Kazenzi/The-robotic-farmer/README.md

# 🚜 Decentralized Robotic Farming 🤖

Click the Youtube Thumbnail below for a youtube demo video: 
<div align="center">
  <a href="http://www.youtube.com/watch?v=3aW1EPtWOO4" target="_blank" style="position: relative; display: inline-block;">
    Video Title
    YouTube Logo
  </a>
</div>

## Overview

*Decentralized Robotic Farming* a.k.a "The Robotic Farmer" is an innovative solution that combines IoT technology and blockchain to enhance transparency, efficiency, and trust in agricultural practices. Our application enables real-time monitoring of farm conditions and automatic mechanized responses to address issues, all while securely storing farming data for easy access. The Robotic Farmer aims to improve crop yields, reduce resource wastage, and foster a more sustainable agricultural ecosystem.

Play with it live on: **[https://mkulima-welcome.vercel.app/](https://mkulima-welcome.vercel.app/)**

Our application applies the use of a smart contract deployed on the Base Mainnet. To verify, click [here](https://basescan.org/tx/0xa0cec8370d50e3738e3875305d2406a3c49cf04a951348cc5778b26b3b8fc69f) 

Proof that we have made 1+ transactions on Base for the project: [Transactions Made by mrsamuelkaruingi.base.eth](https://basescan.org/address/0xe854a712AE100D1089e1490179Ea1C1F786b56cc)

Contract Address: 0xcbb03c0470c16f5e1065cc8379252062e0d8d3d4

To explore further details, visit [BaseScan](https://basescan.org/) and paste the contract address above.

## <u>Table of Contents</u>
- [Problem Statement](#problem-statement)
- [Our Solution](#our-solution)
- [Key Features](#key-features)
- [Research Avenues](#research-avenues)
- [Installation](#installation)
- [Usage](#usage)
- [Future Enhancements](#future-enhancements)
- [Contributors](#contributors)
- [License](#license)

## Problem Statement

Agriculture today faces several challenges:
- Lack of trust and transparency between stakeholders.
- Absence of mechanized systems to respond to changing conditions.
- No proof of proper farming conditions, leading to wrongful accusations.
- Limited access to reliable, data-driven decision-making tools.

## Our Solution

We leverage IoT-enabled agriculture combined with Web 3 integration to create a robust platform for monitoring and managing farm conditions:
- *Real-time Monitoring*: Continuous data collection from various sensors.
- *Autonomous Robotics*: Implementation of robotic systems that autonomously perform tasks such as irrigation and fertilization based on real-time data.
- *Blockchain Storage*: Immutable records stored on IPFS, ensuring tamper-proof data.
- *Smart Contracts*: Automated updates and audits for all farm operations.

## Key Features

- *IoT Sensors*: Utilizes ultrasonic, soil temperature, water level, moisture, rainfall, and NPK sensors.
- *Automation*: Automatically manages irrigation and nutrient dosing based on real-time data.
- *Transparent Record-Keeping*: Immutable records on the blockchain provide legal protection for farmers.
- *Data Accessibility*: Stakeholders can access real-time data and historical records through an intuitive dashboard.
  
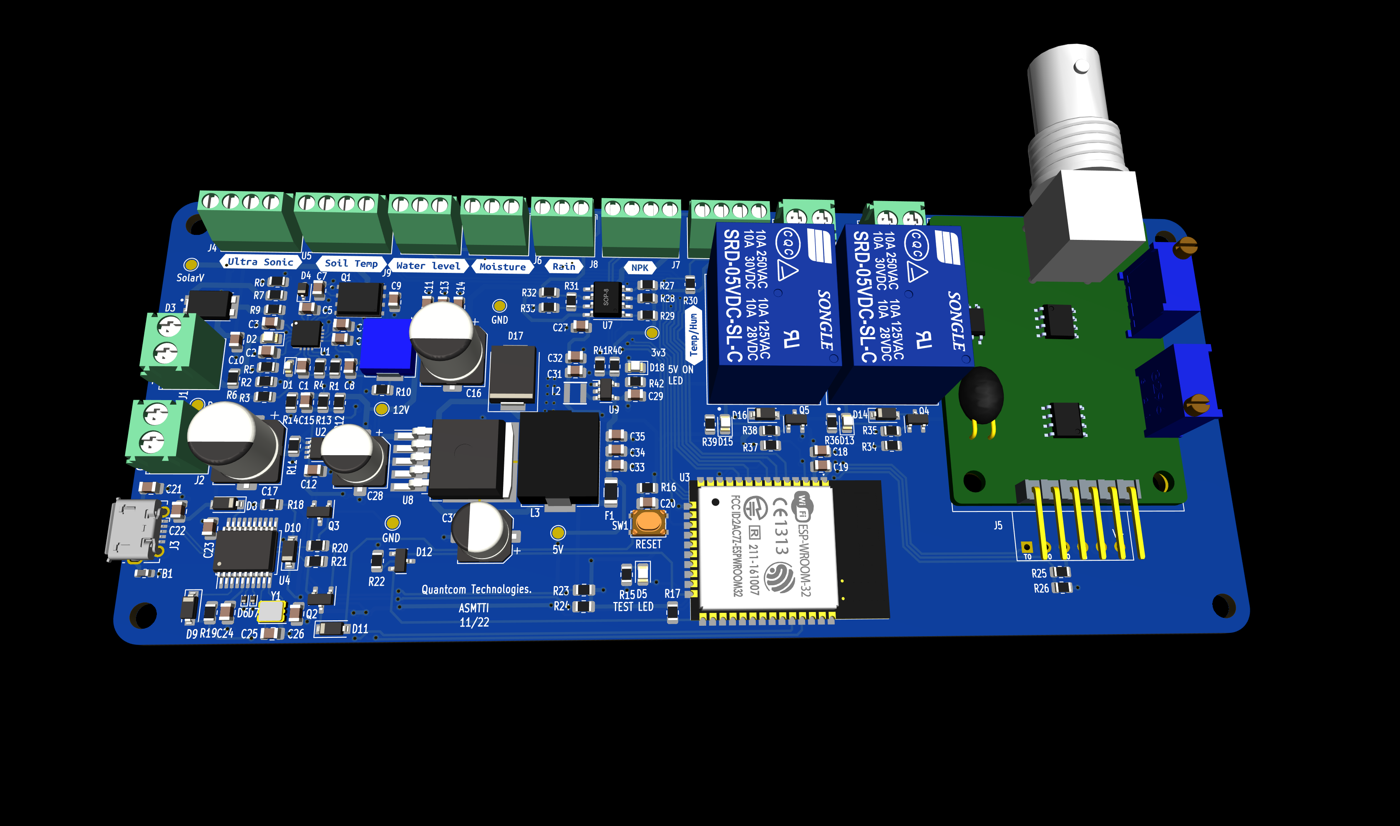
[picture p1: hardware_top.png]

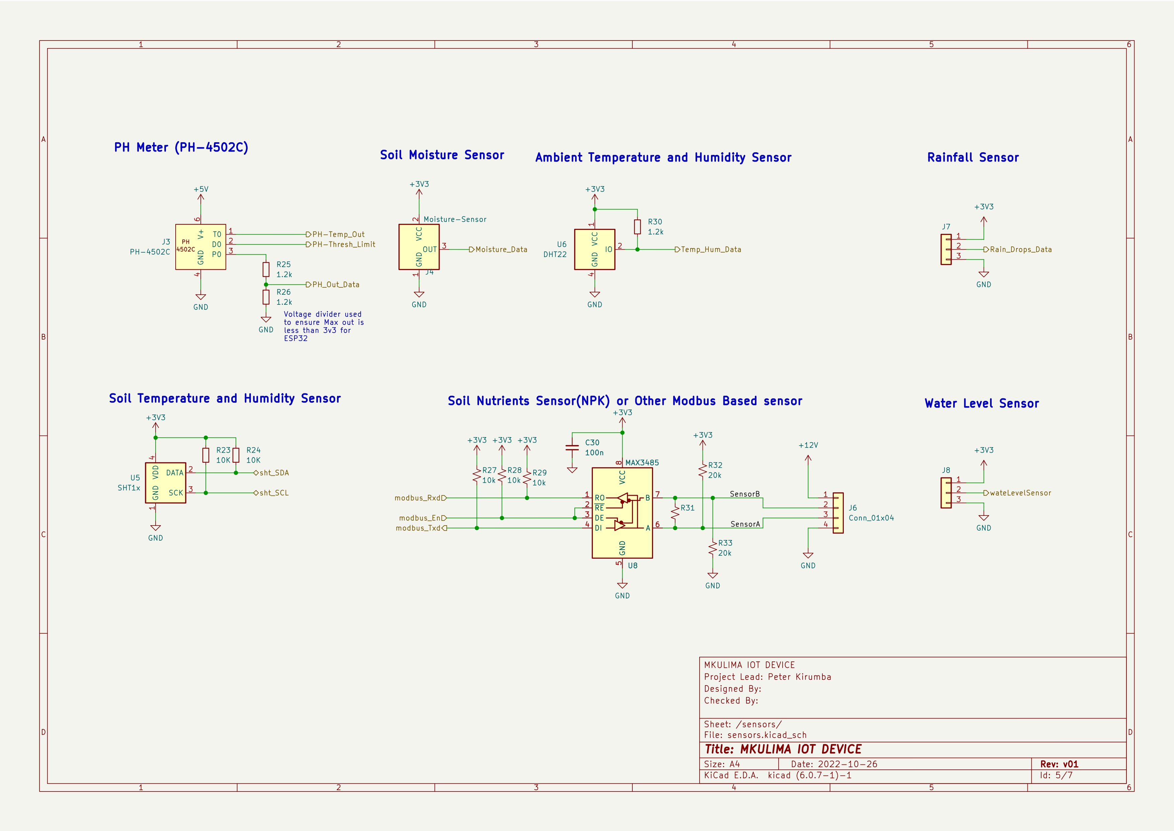
[picture p2: IoT-skeleton-setup.jpg]

<div align="center">
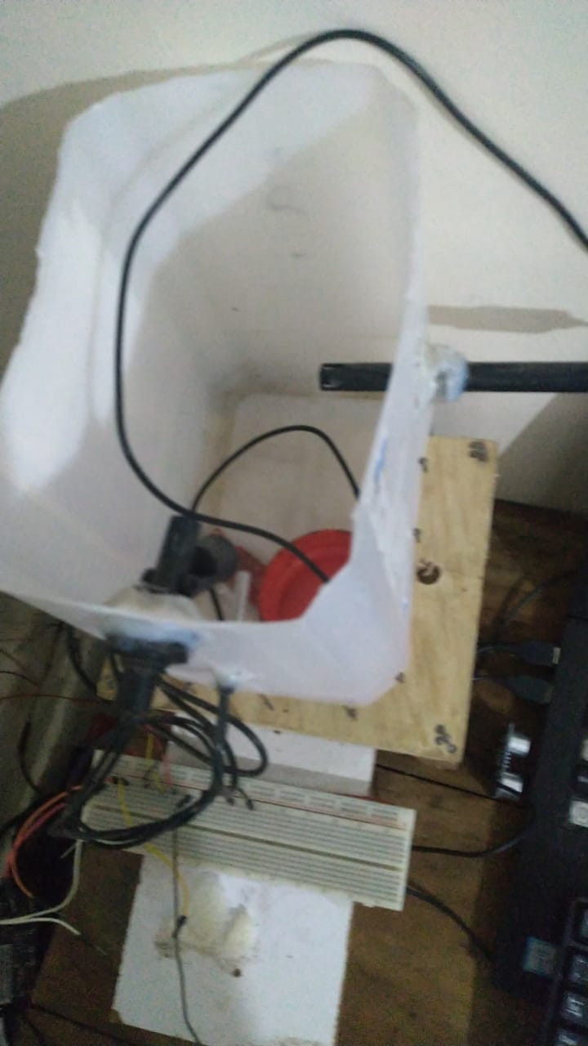
[picture p3: board.jpeg]
Description
    
</div>  

<br><br>

## Research Avenues
**1. Computer and Electrical/Electronics Engineering**

**2. Mechatronics and Robotics Engineering**

**3. Microprocessor Technology/ Embedded Systems** 

**4. Instrumentation and Control**

**5. Physics and Solar Energy**
   
<br>

Play with it live on: **[https://mkulima-welcome.vercel.app/](https://mkulima-welcome.vercel.app/)**

## Installation

**NOTE:** Code to control the hardware can be found in "mkulima_hardware/src". For IoT development strictly use equipment and documentation as specified. 

1. **Clone the Repository:**
   ```bash
   git clone https://github.com/Kazenzi/The-robotic-farmer.git
   cd The-robotic-farmer
   ```

2. **Install Dependencies:**
   ```bash
   npm install
   ```

   <br />

## Locally run

```sh
# Install bun in case you don't have it
curl -fsSL https://bun.sh/install | bash

# Install packages
bun i

# Run Next app
bun run dev
```
<br />

## Usage

1. **Run the Application:** Start the application by running:
   ```bash
   node index.js
   ```
   You will be prompted by your wallet (MetaMask or similar) to confirm the transaction for gas fees.
   As of the moment, the command will give you latest data from our testing phase but for more precise functionality, kindly use real sensors and connect the app to a bluetooth/wifi network to receive real-time data.
   
2. **Interact with the Smart Contract:**
   The `updateCID.js` script should update the IPFS CID for the latest sensor data automatically.
   - Confirm the transaction prompt when updating the CID.
   - You can use mock data to test the application if you do not have sensors.

The front end is fully functional and user-friendly. Ensure all necessary requirements are installed to run the app on your machine.
   
## Future Enhancements

- *Automatic Alerts*: Notifications for critical thresholds (e.g., low water levels).
- *Gas Fee Estimation*: Display gas fee estimates before transactions.
- *Offline Functionality*: Access sensor data offline.
- *Data Visualizations*: Implement charts for data trends over time to help farmers make informed decisions.

## Contributors

- [Samuel Njoroge](https://github.com/sammmmlikescoding)
- [Jacinta Kazenzi](https://github.com/Kazenzi)

## License

This project is licensed under the MIT License - see the [LICENSE](LICENSE) file for details.
