Kazenzi/The-robotic-farmer/hardware_side.png

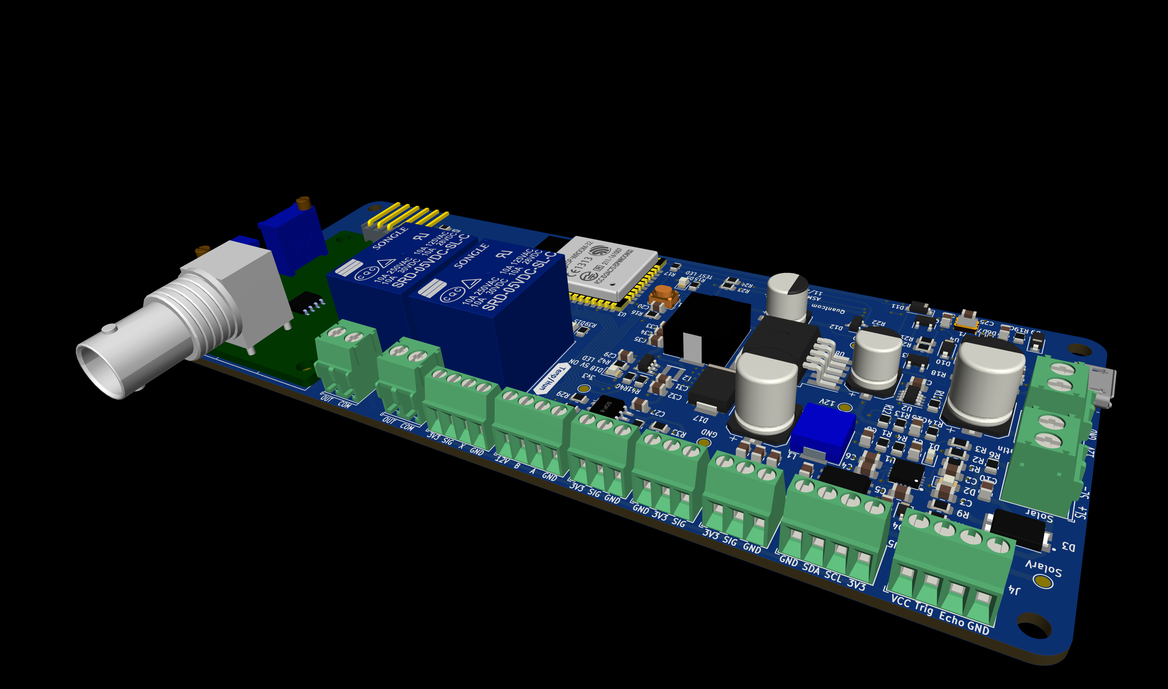
hardware_side.png
