Kazenzi/The-robotic-farmer/mkulima_hardware/img/mkulima_hardware_bottom.png

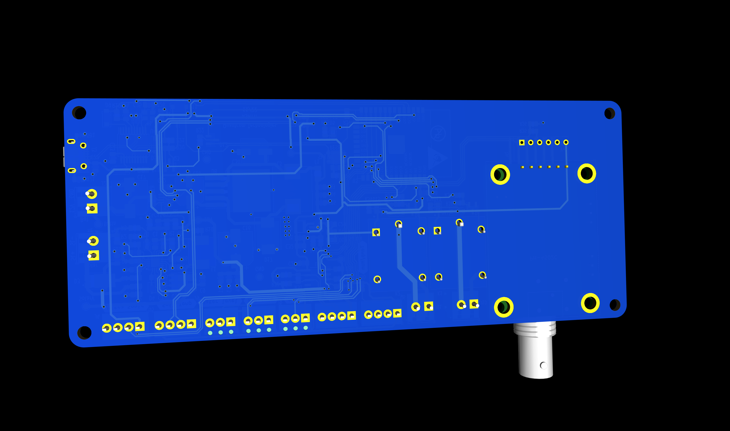
mkulima_hardware/img/mkulima_hardware_bottom.png
