Kazenzi/The-robotic-farmer/mkulima_hardware/img/mkulima_hardware_side_top1.png

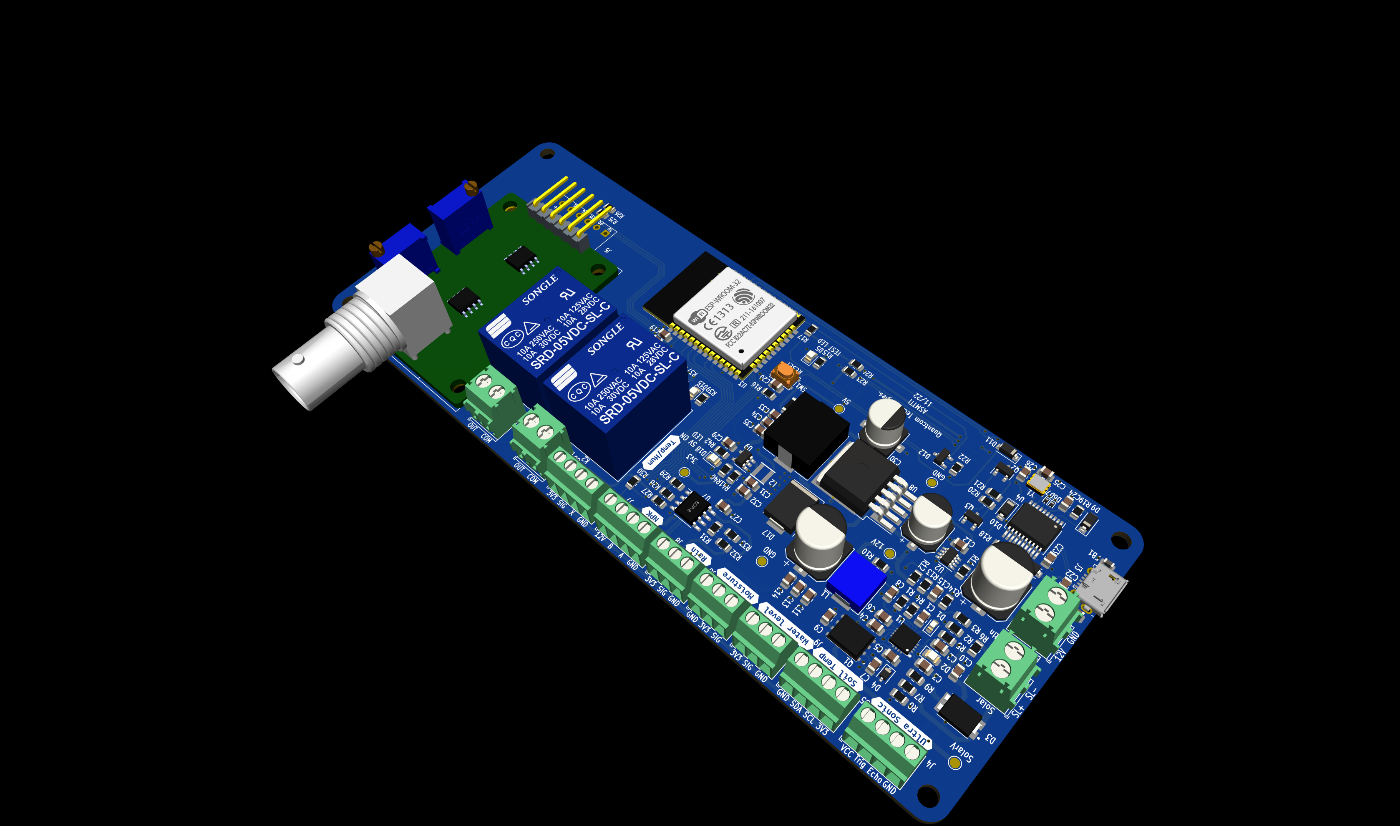
mkulima_hardware/img/mkulima_hardware_side_top1.png
