Kazenzi/The-robotic-farmer/public/robot-farmer.jpg

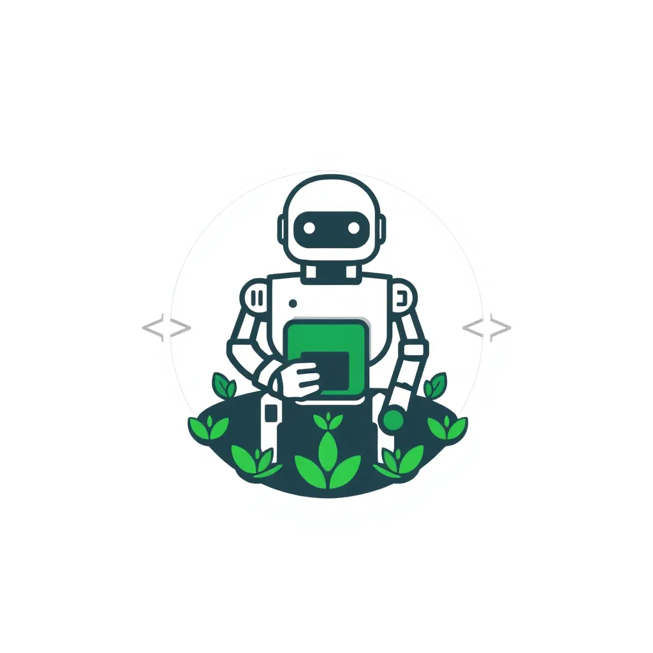
public/robot-farmer.jpg
