Kazenzi/The-robotic-farmer/mkulima_hardware/bom/mkulima_hardware.xlsx

Comment | Designator | Footprint | JLCPCB#
1u | C1, C2, C3, C7, C8, C10, C14, C20 | Capacitor_SMD:C_0805_2012Metric | C28323
0.1u | C4, C5, C6 | Capacitor_SMD:C_0805_2012Metric | C28233
10u | C9, C13, C18, C22, C34 | Capacitor_SMD:C_0805_2012Metric | C361063
47u | C11, C31 | Capacitor_SMD:C_0805_2012Metric | C76636
100n | C12, C19, C27, C32, C33, C35 | Capacitor_SMD:C_0805_2012Metric | C28233
22p | C15 | Capacitor_SMD:C_0805_2012Metric | C24658
22u | C16, C17 | Capacitor_SMD:CP_Elec_8x10 | C249488
10n | C21 | Capacitor_SMD:C_0805_2012Metric | C1710
22uF | C23 | Capacitor_SMD:C_0805_2012Metric | C602037
100nF | C24 | Capacitor_SMD:C_0805_2012Metric | C28233
22pF | C25, C26 | Capacitor_SMD:C_0805_2012Metric | C24658
470u | C28 | Capacitor_SMD:CP_Elec_6.3x7.7 | C393770
22u | C29 | Capacitor_SMD:C_0805_2012Metric | C602037
470u | C30 | Capacitor_SMD:C_0805_2012Metric | C393770
GREEN | D1 | LED_SMD:LED_0603_1608Metric | C84267
RED | D2 | LED_SMD:LED_0805_2012Metric | C434419
PDS1040 | D3 | greencharge-footprints:PDS104013 | C110512
D_Small | D4 | Diode_SMD:D_SOD-323 | C181207
LED_Small | D5, D13, D15, D18 | LED_SMD:LED_0805_2012Metric | C965790
D_TVS_Filled | D6, D7 | Diode_SMD:D_SOD-923 | C316040
D_Schottky_Small | D8 | Diode_SMD:D_SOD-123 | C908229
B5819W | D9, D10, D11 | Diode_SMD:D_SOD-123 | C8598
BAT54C | D12 | Package_TO_SOT_SMD:SOT-23 | C181200
D_Small | D14, D16 | Diode_SMD:D_SOD-123 | C908229
D_Small | D17 | Diode_SMD:D_SMC | C511858
ASMD1206-200 | F1 | Fuse:Fuse_1206_3216Metric | C135342
FerriteBead_Small | FB1 | Inductor_SMD:L_0603_1608Metric | C14709
Conn_01x02 | J1, J2 | TerminalBlock_Phoenix:TerminalBlock_Phoenix_PT-1,5-2-3.5-H_1x02_P3.50mm_Horizontal | C784942
USB_B_Micro | J3 | Connector_USB:USB_Micro-B_Molex-105017-0001 | C136000
Conn_01x04 | J4, J7 | TerminalBlock_Phoenix:TerminalBlock_Phoenix_MPT-0,5-4-2.54_1x04_P2.54mm_Horizontal | C2691448
Moisture-Sensor | J6 | TerminalBlock_Phoenix:TerminalBlock_Phoenix_MPT-0,5-3-2.54_1x03_P2.54mm_Horizontal | C49257
Conn_01x03 | J8, J9 | TerminalBlock_Phoenix:TerminalBlock_Phoenix_MPT-0,5-3-2.54_1x03_P2.54mm_Horizontal | C49257
Screw_Terminal_01x02 | J10, J11 | TerminalBlock_Phoenix:TerminalBlock_Phoenix_PT-1,5-2-3.5-H_1x02_P3.50mm_Horizontal | C784942
SRD-05VDC-SL-C | K1, K2 | greencharge-footprints:SRD-05VDC-SL-C | C35449
3.3uH | L1 | greencharge-footprints:MHCI06030-3R3M-R8 | C108294
2.2u | L2 | greencharge-footprints:NR3015T2R2M | C86423
33u | L3 | greencharge-footprints:YSPI1050-xxx | YSPI1050-3R3M
SI7288DP-T1-GE3 | Q1 | greencharge-footprints:SI7288DP-T1-GE3 | C126988
MMBT3904 | Q2, Q3, Q4, Q5 | Package_TO_SOT_SMD:SOT-23 | C20526
5.23k | R1 | Resistor_SMD:R_0805_2012Metric | C304851
30.1k | R2 | Resistor_SMD:R_0805_2012Metric | C21841
10k | R3, R4, R6, R17, R18, R19, R20, R21, R27, R28, R29 | Resistor_SMD:R_0805_2012Metric | C17414
100R | R5 | Resistor_SMD:R_0805_2012Metric | C17408
499k | R7, R13 | Resistor_SMD:R_0805_2012Metric | C17721
36k | R8 | Resistor_SMD:R_0805_2012Metric | C4360
10R | R9 | Resistor_SMD:R_0805_2012Metric | C17415
0.002R | R10 | Resistor_SMD:R_0805_2012Metric | WW08RR002FTL
0.1R | R11 | Resistor_SMD:R_0805_2012Metric | C125639
0R | R12 | Resistor_SMD:R_0805_2012Metric | C17477
100k | R14 | Resistor_SMD:R_0805_2012Metric | C149504
220R | R15 | Resistor_SMD:R_0805_2012Metric | C17557
10k | R16 | Resistor_SMD:R_0805_2012Metric | C17414
220R | R22 | Resistor_SMD:R_0805_2012Metric | C17557
10K | R23, R24 | Resistor_SMD:R_0805_2012Metric | C17414
1.2k | R25, R26, R30 | Resistor_SMD:R_0805_2012Metric | C17379
~ | R31 | Resistor_SMD:R_0805_2012Metric | C17477
20k | R32, R33 | Resistor_SMD:R_0805_2012Metric | C4328
470R | R34, R36, R37, R39, R42 | Resistor_SMD:R_0805_2012Metric | C17710
10k | R35, R38 | Resistor_SMD:R_0805_2012Metric | C17414
220k | R40 | Resistor_SMD:R_0805_2012Metric | C17556
49.9k | R41 | Resistor_SMD:R_0805_2012Metric | C17719
SW_Push | SW1 | greencharge-footprints:SKRPACE010 | C139797
BQ24650RVAR | U1 | greencharge-footprints:BQ24650RVAR | C53712
INA219AxDCN | U2 | Package_TO_SOT_SMD:SOT-23-8 | C87469
ESP-32S | U3 | greencharge-footprints:ESP-32S | C701341
CH340T(SSOP20W) | U4 | Package_SO:SSOP-20_5.3x7.2mm_P0.65mm | C8689
SHT1x | U5 | TerminalBlock_Phoenix:TerminalBlock_Phoenix_MPT-0,5-4-2.54_1x04_P2.54mm_Horizontal | C918122
DHT22 | U6 | TerminalBlock_Phoenix:TerminalBlock_Phoenix_MPT-0,5-4-2.54_1x04_P2.54mm_Horizontal | C918122
MAX3485 | U7 | Package_SO:SOP-8_3.9x4.9mm_P1.27mm | C519082
LM2596S-5.0 | U8 | Package_TO_SOT_SMD:TO-263-5_TabPin3 | C347421
SY8089AAAC | U9 | Package_TO_SOT_SMD:SOT-23-5 | C78988
12MHz | Y1 | Crystal:Crystal_SMD_2520-4Pin_2.5x2.0mm | C90603
SHT1x | U5 | TerminalBlock_Phoenix:TerminalBlock_Phoenix_MPT-0,5-4-2.54_1x04_P2.54mm_Horizontal | C2880291
DHT22 | U6 | TerminalBlock_Phoenix:TerminalBlock_Phoenix_MPT-0,5-4-2.54_1x04_P2.54mm_Horizontal | C2880291
