Kazenzi/The-robotic-farmer/mkulima_hardware/src/mkulima_hardware.kicad_pcb

## KiCad design mkulima_hardware/src/mkulima_hardware.kicad_pcb (2024-10-19)

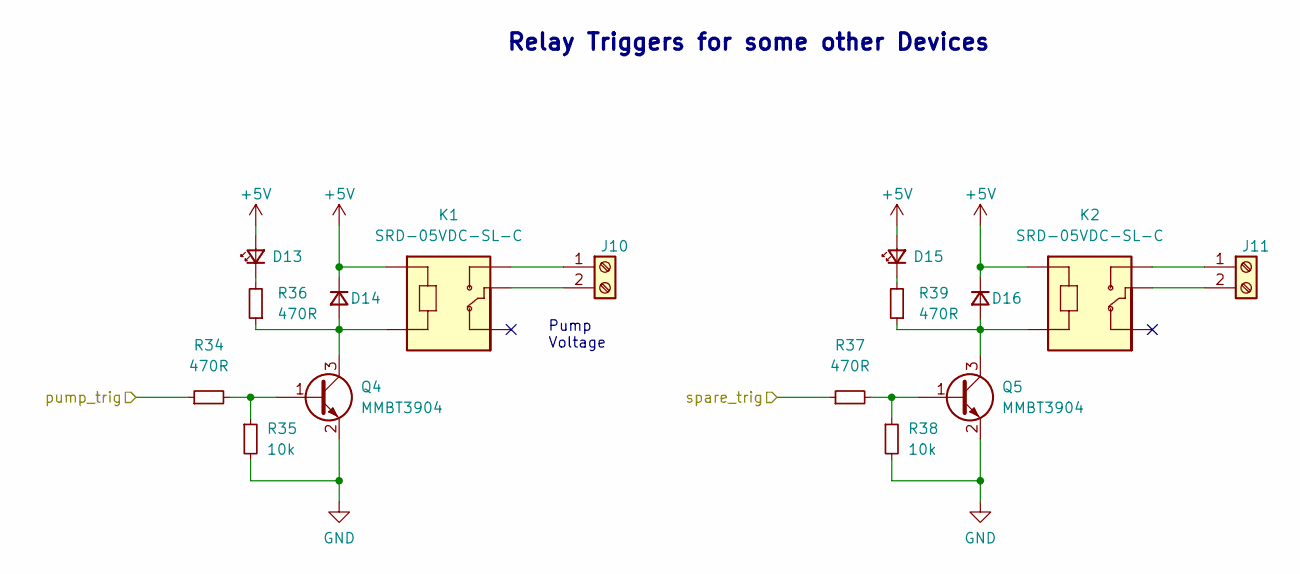
[picture p8: schematic actuators.kicad_sch, MKULIMA IOT DEVICE]

Parts:
D13, D15: LED_Small; LED_0805_2012Metric
D14, D16: D_Small; D_SOD-123
J10, J11: Screw_Terminal_01x02; TerminalBlock_Phoenix_PT-1,5-2-3.5-H_1x02_P3.50mm_Horizontal
K1, K2: SRD-05VDC-SL-C
Q4, Q5: MMBT3904; SOT-23
R34, R36, R37, R39: 470R; R_0805_2012Metric
R35, R38: 10k; R_0805_2012Metric

Connections:
+5V: D13.2 (A), D14.1 (K), D15.2 (A), D16.1 (K), K1.A1, K2.A1; also elsewhere on the board
/ESP32_logic_control/pumpTrig: R34.1; also elsewhere on the board
/ESP32_logic_control/spareTrig: R37.1; also elsewhere on the board
unnamed: D13.1 (K), R36.2
unnamed: D14.2 (A), K1.A2, Q4.3 (C), R36.1
unnamed: D15.1 (K), R39.2
unnamed: D16.2 (A), K2.A2, Q5.3 (C), R39.1
unnamed: J10.1, K1.NO
unnamed: J10.2, K1.COM
unnamed: J11.1, K2.NO
unnamed: J11.2, K2.COM
unnamed: Q4.1 (B), R34.2, R35.1
unnamed: Q5.1 (B), R37.2, R38.1

Notes on the sheet:
Relay Triggers for some other Devices
Pump Voltage

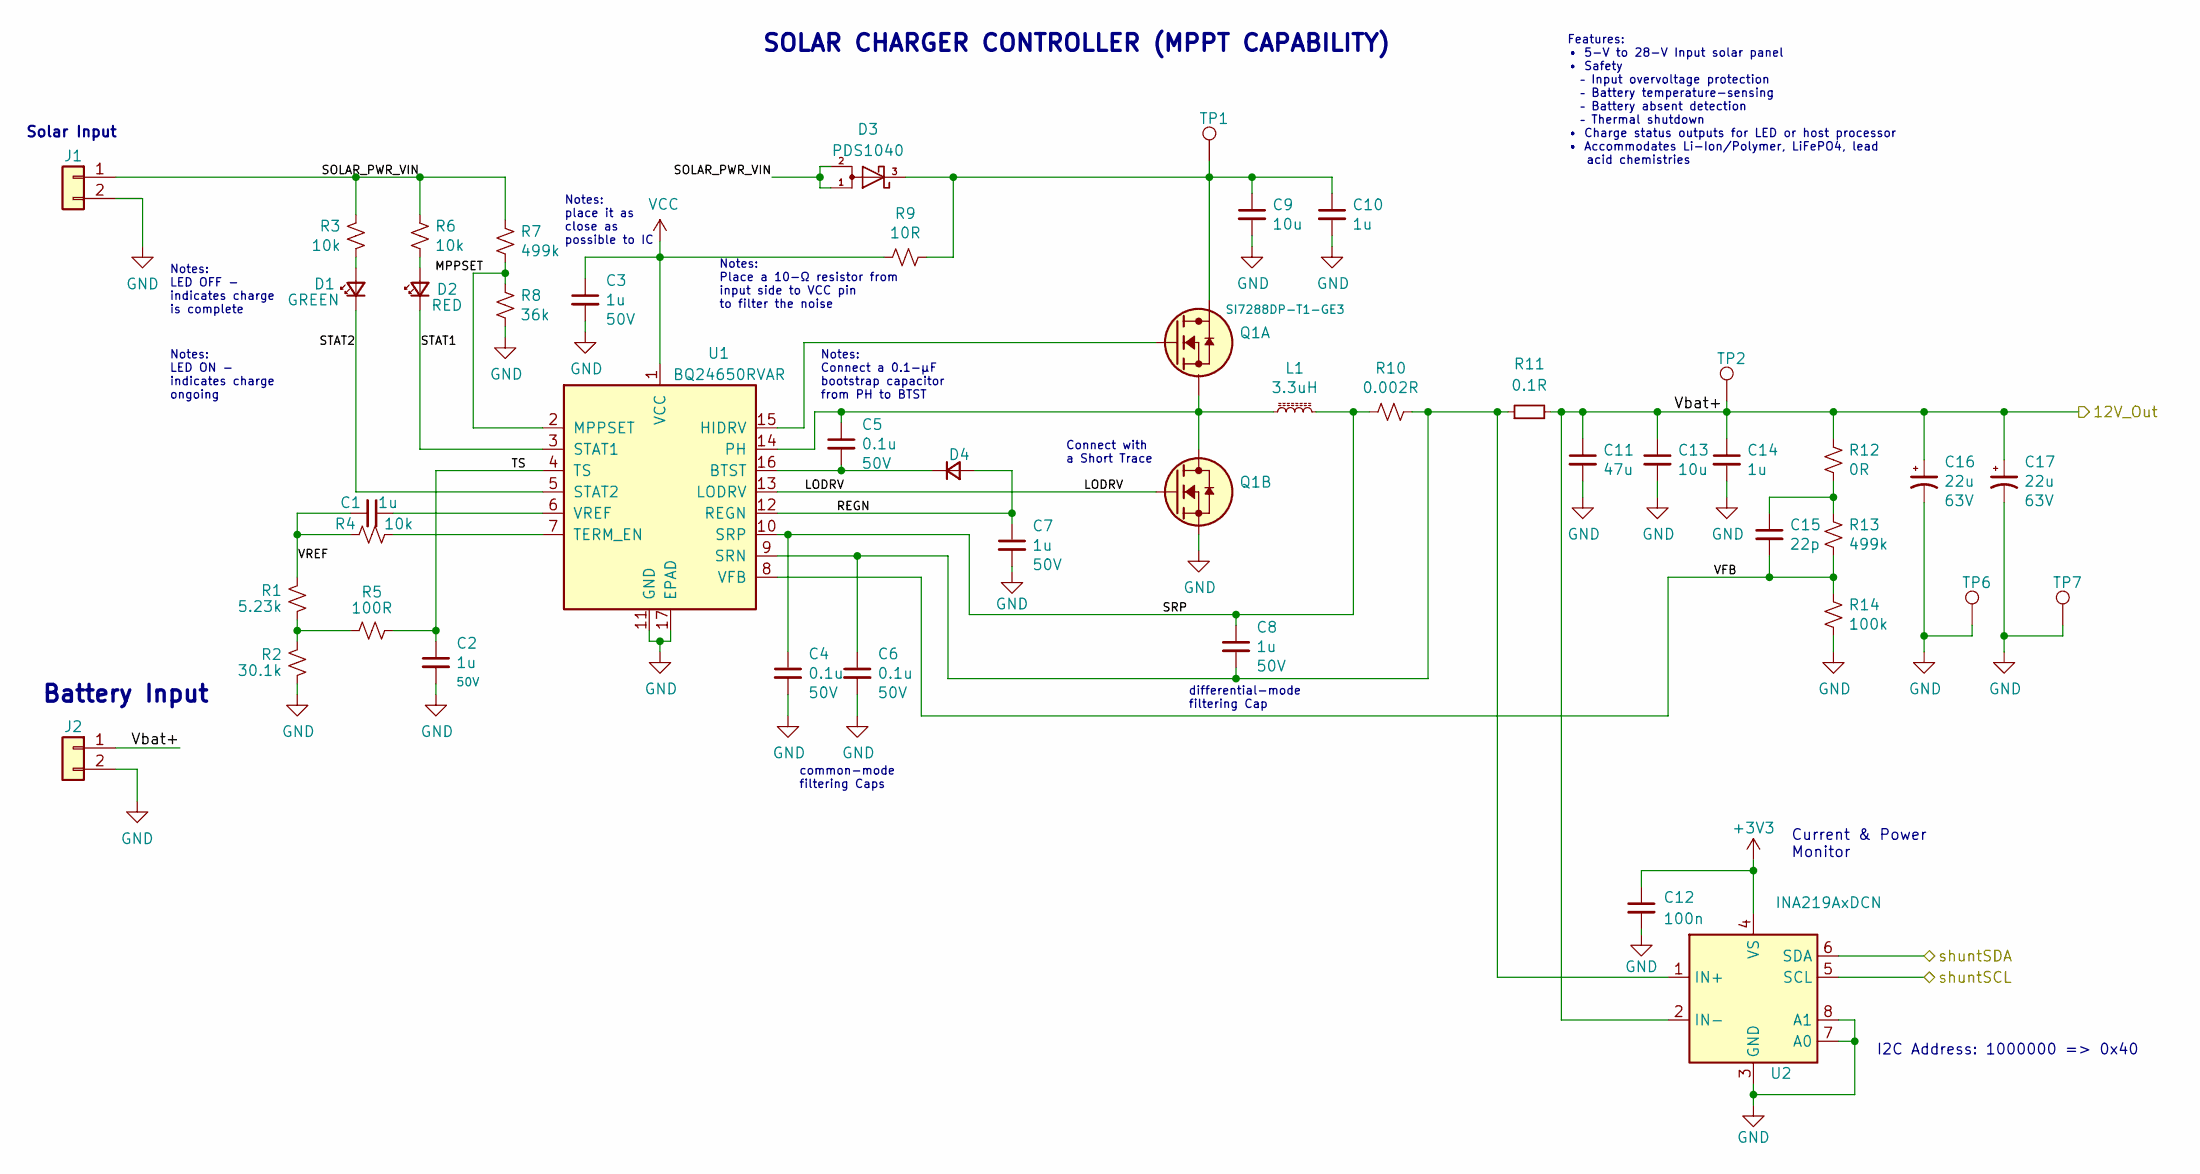
[picture p9: schematic solar_mppt_power_supply.kicad_sch, MKULIMA IOT DEVICE]

Parts:
C1, C10, C14: 1u; C_0805_2012Metric
C2, C3, C7, C8: 1u; C_0805_2012Metric; Voltage 50V
C4, C5, C6: 0.1u; C_0805_2012Metric; Voltage 50V
C9, C13: 10u; C_0805_2012Metric
C11: 47u; C_0805_2012Metric
C12: 100n; C_0805_2012Metric
C15: 22p; C_0805_2012Metric
C16, C17: 22u; CP_Elec_8x10; Voltage 63V; MPN VE-220M1JTR-0810
D1: GREEN; LED_0603_1608Metric
D2: RED; LED_0805_2012Metric
D3: PDS1040; PDS104013
D4: D_Small; D_SOD-323
J1, J2: Conn_01x02; TerminalBlock_Phoenix_PT-1,5-2-3.5-H_1x02_P3.50mm_Horizontal
L1: 3.3uH; MHCI06030-3R3M-R8; MPN MHCI06030-3R3M-R8
Q1: SI7288DP-T1-GE3; MPN SI7288DP-T1-GE3
R1: 5.23k; R_0805_2012Metric
R2: 30.1k; R_0805_2012Metric
R3, R4, R6: 10k; R_0805_2012Metric
R5: 100R; R_0805_2012Metric
R7, R13: 499k; R_0805_2012Metric
R8: 36k; R_0805_2012Metric
R9: 10R; R_0805_2012Metric
R10: 0.002R; R_0805_2012Metric
R11: 0.1R; R_0805_2012Metric
R12: 0R; R_0805_2012Metric
R14: 100k; R_0805_2012Metric
TP1, TP2, TP6, TP7: TestPoint; TestPoint_Pad_D1.5mm
U1: BQ24650RVAR
U2: INA219AxDCN; SOT-23-8

Connections:
+3V3: C12.1, U2.4 (VS); also elsewhere on the board
+12V: C11.1, C13.1, C14.1, C16.1, C17.1, J2.1, R11.2, R12.1, TP2.1, U2.2 (IN-); also elsewhere on the board
/scl: U2.5 (SCL); also elsewhere on the board
/sda: U2.6 (SDA); also elsewhere on the board
/solar_mppt_power_supply/LODRV: Q1.4, U1.13 (LODRV)
/solar_mppt_power_supply/MPPSET: R7.2, R8.1, U1.2 (MPPSET)
/solar_mppt_power_supply/REGN: C7.1, D4.2 (A), U1.12 (REGN)
/solar_mppt_power_supply/SOLAR_PWR_VIN: D3.1 (A), D3.2 (A), J1.1, R3.1, R6.1, R7.1
/solar_mppt_power_supply/SRP: C4.1, C8.1, L1.2, R10.2, U1.10 (SRP)
/solar_mppt_power_supply/STAT1: D2.1 (K), U1.3 (STAT1)
/solar_mppt_power_supply/STAT2: D1.1 (K), U1.5 (STAT2)
/solar_mppt_power_supply/TS: C2.1, R5.1, U1.4 (TS)
/solar_mppt_power_supply/VFB: C15.2, R13.2, R14.1, U1.8 (VFB)
/solar_mppt_power_supply/VREF: C1.2, R1.1, R4.2
unnamed: C1.1, U1.6 (VREF)
unnamed: C5.1, L1.1, Q1.1, Q1.5, Q1.6, Q1.10, U1.14 (PH)
unnamed: C5.2, D4.1 (K), U1.16 (BTST)
unnamed: C6.1, C8.2, R10.1, R11.1, U1.9 (SRN), U2.1 (IN+)
unnamed: C9.1, C10.1, D3.3 (K), Q1.7, Q1.8, Q1.9, R9.1, TP1.1
unnamed: C15.1, R12.2, R13.1
unnamed: D1.2 (A), R3.2
unnamed: D2.2 (A), R6.2
unnamed: Q1.2, U1.15 (HIDRV)
unnamed: R1.2, R2.1, R5.2
unnamed: R4.1, U1.7 (TERM_EN)
VCC: C3.1, R9.2, U1.1 (VCC)

Notes on the sheet:
Notes: Place a 10-Ω resistor from input side to VCC pin to filter the noise
differential-mode filtering Cap
Features: • 5-V to 28-V Input solar panel • Safety – Input overvoltage protection – Battery temperature-sensing – Battery absent detection – Thermal shutdown • Charge status outputs for LED or host processor • Accommodates Li-Ion/Polymer, LiFePO4, lead acid chemistries
Notes: LED OFF - indicates charge is complete
Solar Input
Notes: Connect a 0.1-μF bootstrap capacitor from PH to BTST
Notes: LED ON - indicates charge ongoing
Connect with a Short Trace
Current & Power Monitor
Notes: place it as close as possible to IC
common-mode filtering Caps
Battery Input
SOLAR CHARGER CONTROLLER (MPPT CAPABILITY)
I2C Address: 1000000 => 0x40

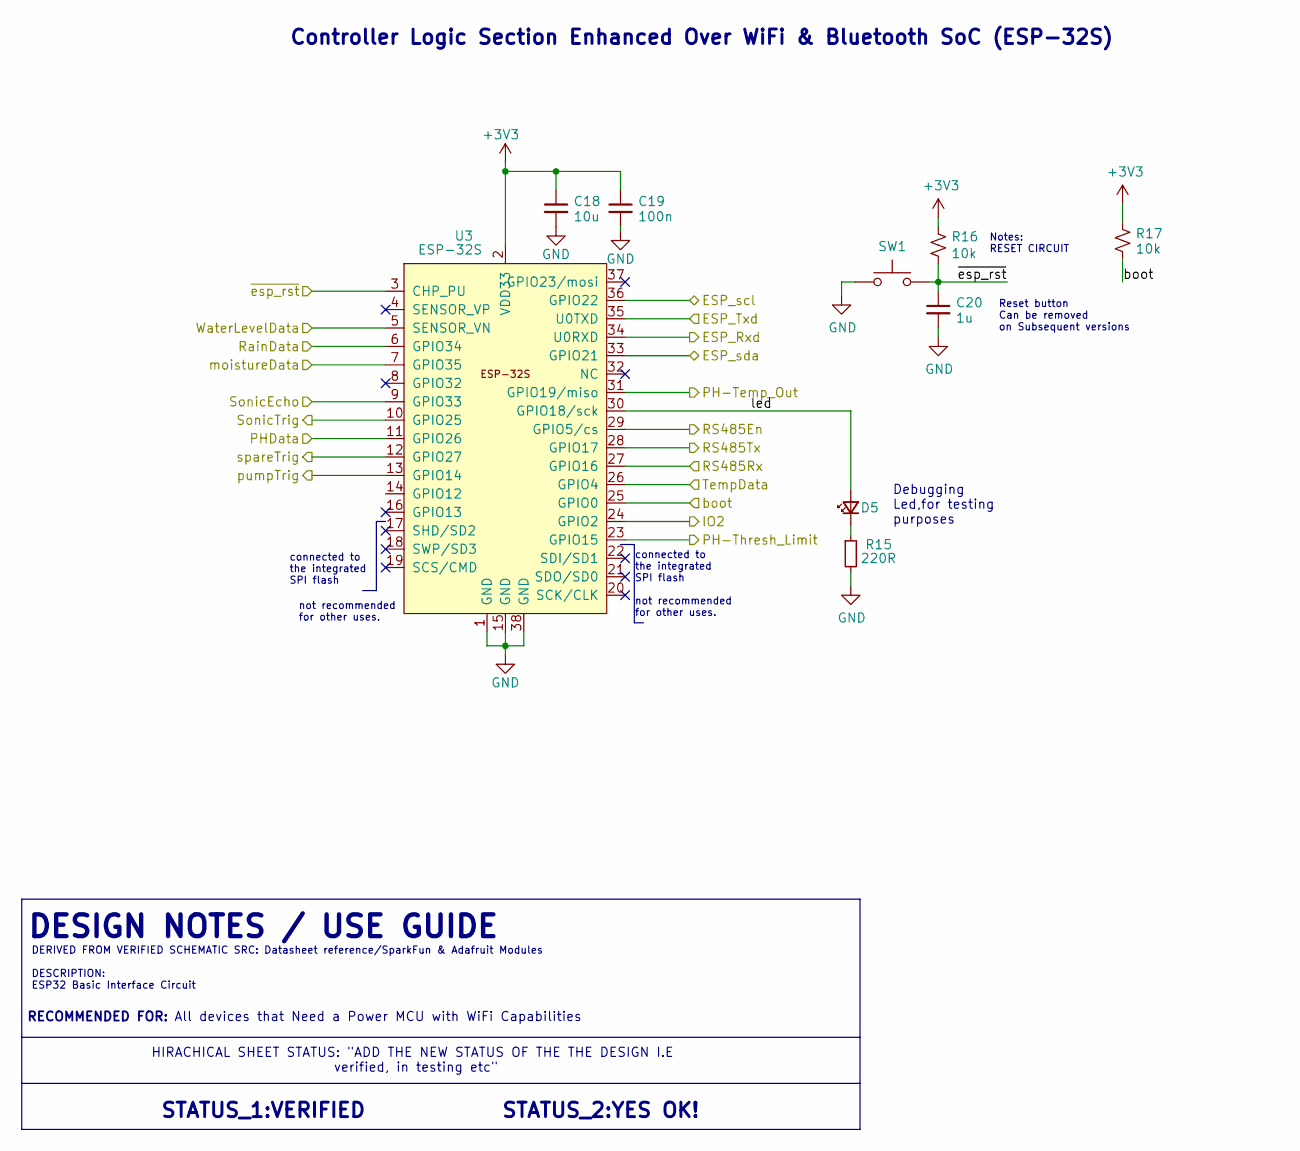
[picture p10: schematic ESP32_logic_control.kicad_sch, MKULIMA IOT DEVICE]

Parts:
C18: 10u; C_0805_2012Metric
C19: 100n; C_0805_2012Metric
C20: 1u; C_0805_2012Metric
D5: LED_Small; LED_0805_2012Metric
R15: 220R; R_0805_2012Metric
R16, R17: 10k; R_0805_2012Metric
SW1: SW_Push; SKRPACE010
U3: ESP-32S

Connections:
+3V3: C18.1, C19.1, R16.1, R17.1, U3.2 (VDD33); also elsewhere on the board
/ESP32_logic_control/ESP_Rxd: U3.34 (U0RXD); also elsewhere on the board
/ESP32_logic_control/ESP_Txd: U3.35 (U0TXD); also elsewhere on the board
/ESP32_logic_control/IO2: U3.24 (GPIO2); also elsewhere on the board
/ESP32_logic_control/PH-Temp_Out: U3.31 (GPIO19/miso); also elsewhere on the board
/ESP32_logic_control/PH-Thresh_Limit: U3.23 (GPIO15); also elsewhere on the board
/ESP32_logic_control/PHData: U3.11 (GPIO26); also elsewhere on the board
/ESP32_logic_control/RS485En: U3.29 (GPIO5/cs); also elsewhere on the board
/ESP32_logic_control/RS485Rx: U3.27 (GPIO16); also elsewhere on the board
/ESP32_logic_control/RS485Tx: U3.28 (GPIO17); also elsewhere on the board
/ESP32_logic_control/RainData: U3.6 (GPIO34); also elsewhere on the board
/ESP32_logic_control/SonicEcho: U3.9 (GPIO33); also elsewhere on the board
/ESP32_logic_control/SonicTrig: U3.10 (GPIO25); also elsewhere on the board
/ESP32_logic_control/TempData: U3.26 (GPIO4); also elsewhere on the board
/ESP32_logic_control/WaterLevelData: U3.5 (SENSOR_VN); also elsewhere on the board
/ESP32_logic_control/boot: R17.2, U3.25 (GPIO0); also elsewhere on the board
/ESP32_logic_control/led: D5.2 (A), U3.30 (GPIO18/sck)
/ESP32_logic_control/moistureData: U3.7 (GPIO35); also elsewhere on the board
/ESP32_logic_control/pumpTrig: U3.13 (GPIO14); also elsewhere on the board
/ESP32_logic_control/spareTrig: U3.12 (GPIO27); also elsewhere on the board
/ESP32_logic_control/~esp_rst: C20.1, R16.2, SW1.2, U3.3 (CHP_PU); also elsewhere on the board
/scl: U3.36 (GPIO22); also elsewhere on the board
/sda: U3.33 (GPIO21); also elsewhere on the board
unnamed: D5.1 (K), R15.1

Notes on the sheet:
STATUS_2:YES OK!
STATUS_1:VERIFIED
Debugging Led,for testing purposes
Reset button Can be removed on Subsequent versions
DERIVED FROM VERIFIED SCHEMATIC SRC: Datasheet reference/SparkFun & Adafruit Modules DESCRIPTION: ESP32 Basic Interface Circuit
not recommended for other uses.
DESIGN NOTES / USE GUIDE
HIRACHICAL SHEET STATUS: "ADD THE NEW STATUS OF THE THE DESIGN I.E verified, in testing etc"
Controller Logic Section Enhanced Over WiFi & Bluetooth SoC (ESP-32S)
connected to the integrated SPI flash
All devices that Need a Power MCU with WiFi Capabilities
connected to the integrated SPI flash not recommended for other uses.
Notes: RESET CIRCUIT
RECOMMENDED FOR:

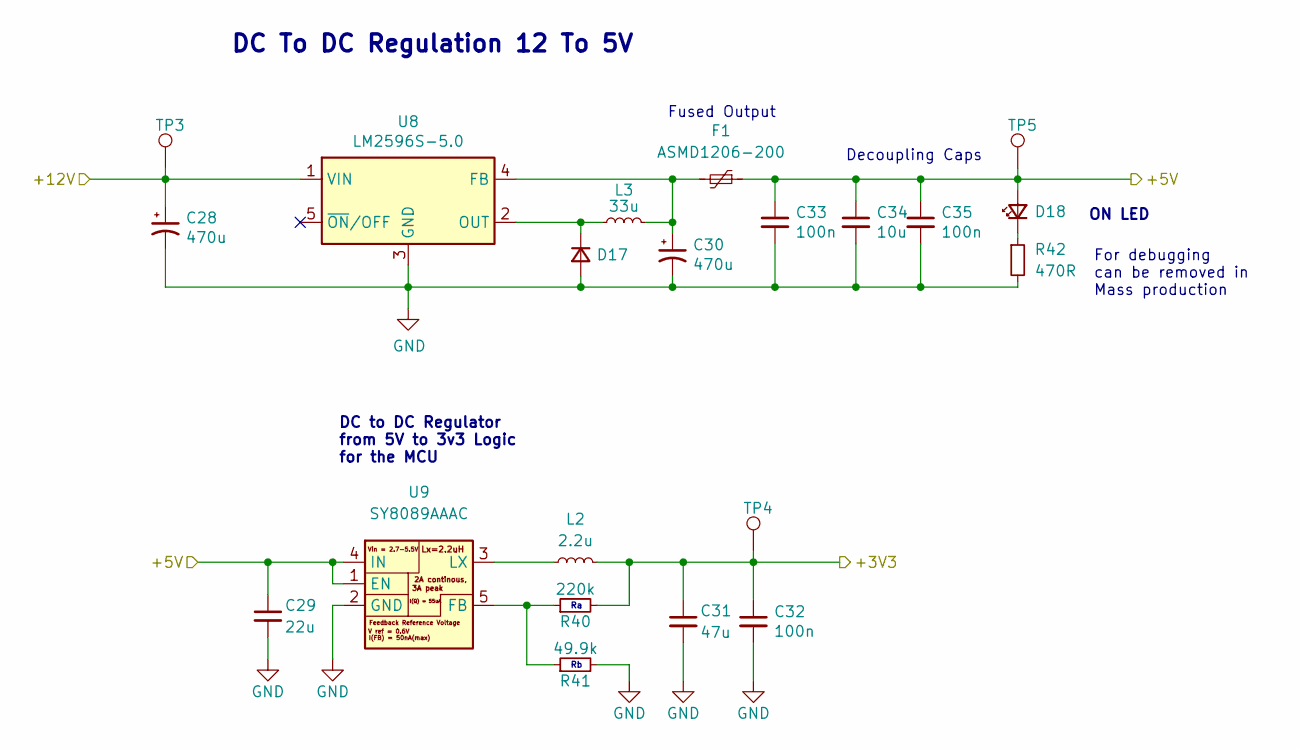
[picture p11: schematic dc_dc_conveter.kicad_sch, MKULIMA IOT DEVICE]

Parts:
C28, C30: 470u; CP_Elec_6.3x7.7; Mfr# UTOJ471M0607VG
C29: 22u; C_0805_2012Metric
C31: 47u; C_0805_2012Metric
C32, C33, C35: 100n; C_0805_2012Metric
C34: 10u; C_0805_2012Metric
D17: D_Small; D_SMC
D18: LED_Small; LED_0805_2012Metric
F1: ASMD1206-200; Fuse_1206_3216Metric; Mfr# ASMD1206-200
L2: 2.2u; NR3015T2R2M; Mfr# NR3015T2R2M
L3: 33u; YSPI1050-xxx
R40: 220k; R_0805_2012Metric
R41: 49.9k; R_0805_2012Metric
R42: 470R; R_0805_2012Metric
TP3, TP4, TP5: TestPoint; TestPoint_Pad_D1.5mm
U8: LM2596S-5.0; TO-263-5_TabPin3
U9: SY8089AAAC; SOT-23-5

Connections:
+3V3: C31.1, C32.1, L2.2, R40.2, TP4.1; also elsewhere on the board
+5V: C29.1, C33.1, C34.1, C35.1, D18.2 (A), F1.1, TP5.1, U9.1 (EN), U9.4 (IN); also elsewhere on the board
+12V: C28.1, TP3.1, U8.1 (VIN); also elsewhere on the board
unnamed: C30.1, F1.2, L3.2, U8.4 (FB)
unnamed: D17.1 (K), L3.1, U8.2 (OUT)
unnamed: D18.1 (K), R42.1
unnamed: L2.1, U9.3 (LX)
unnamed: R40.1, R41.1, U9.5 (FB)

Notes on the sheet:
DC To DC Regulation 12 To 5V
DC to DC Regulator from 5V to 3v3 Logic for the MCU
Fused Output
ON LED
Decoupling Caps
For debugging can be removed in Mass production

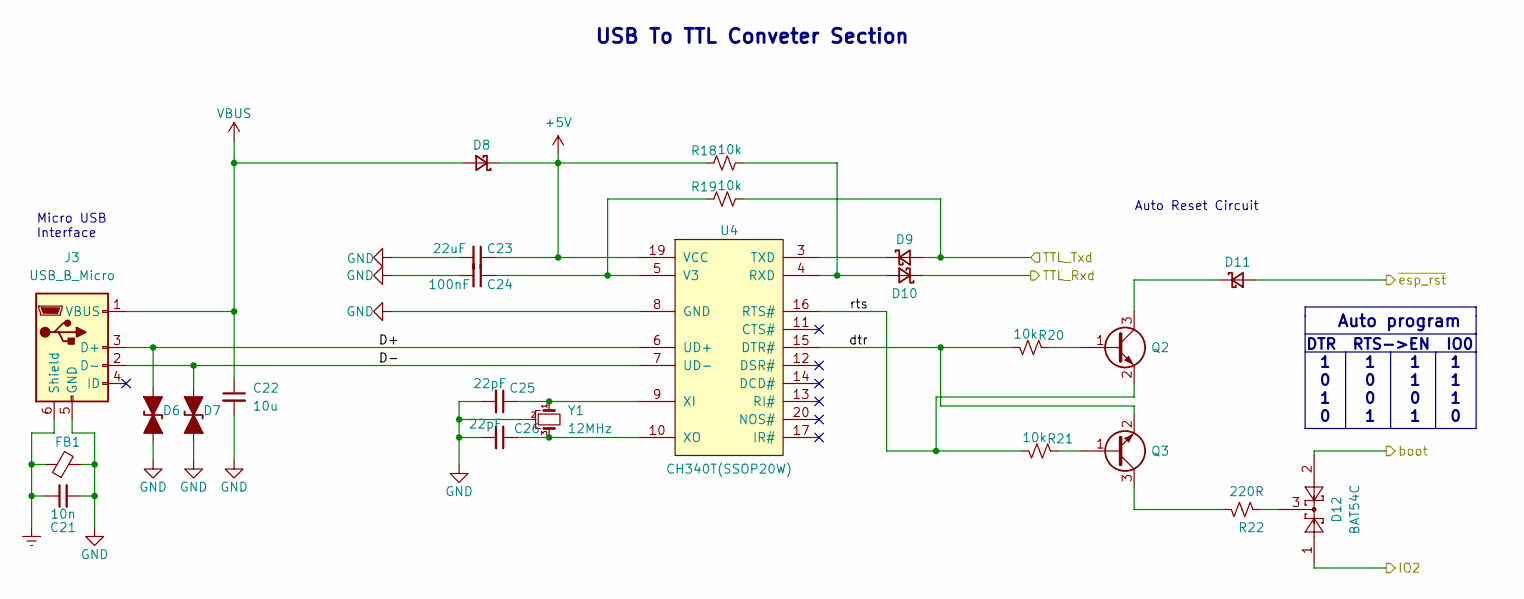
[picture p12: schematic untitled.kicad_sch, MKULIMA IOT DEVICE]

Parts:
C21: 10n; C_0805_2012Metric
C22: 10u; C_0805_2012Metric
C23: 22uF; C_0805_2012Metric
C24: 100nF; C_0805_2012Metric
C25, C26: 22pF; C_0805_2012Metric
D6, D7: D_TVS_Filled; D_SOD-923; Mfr# ESD9B5.0ST5G
D8: D_Schottky_Small; D_SOD-123
D9, D10, D11: B5819W; D_SOD-123
D12: BAT54C; SOT-23
FB1: FerriteBead_Small; L_0603_1608Metric
J3: USB_B_Micro; USB_Micro-B_Molex-105017-0001
Q2, Q3: MMBT3904; SOT-23
R18, R19, R20, R21: 10k; R_0805_2012Metric
R22: 220R; R_0805_2012Metric
U4: CH340T(SSOP20W); SSOP-20_5.3x7.2mm_P0.65mm
Y1: 12MHz; Crystal_SMD_2520-4Pin_2.5x2.0mm

Connections:
+5V: C23.1, D8.1 (K), R18.1, U4.19 (VCC); also elsewhere on the board
/ESP32_logic_control/ESP_Rxd: D9.2 (A), R19.2; also elsewhere on the board
/ESP32_logic_control/ESP_Txd: D10.1 (K); also elsewhere on the board
/ESP32_logic_control/IO2: D12.1; also elsewhere on the board
/ESP32_logic_control/boot: D12.2; also elsewhere on the board
/ESP32_logic_control/~esp_rst: D11.2 (A); also elsewhere on the board
/usb_to_uart_converter/D+: D6.2 (A2), J3.3 (D+), U4.6 (UD+)
/usb_to_uart_converter/D-: D7.2 (A2), J3.2 (D-), U4.7 (UD-)
/usb_to_uart_converter/dtr: Q3.2 (E), R20.2, U4.15 (DTR#)
/usb_to_uart_converter/rts: Q2.2 (E), R21.2, U4.16 (RTS#)
Earth: C21.1, FB1.1, J3.6 (Shield)
unnamed: C24.1, R19.1, U4.5 (V3)
unnamed: C25.1, U4.9 (XI), Y1.1
unnamed: C26.1, U4.10 (XO), Y1.3
unnamed: D9.1 (K), U4.3 (TXD)
unnamed: D10.2 (A), R18.2, U4.4 (RXD)
unnamed: D11.1 (K), Q2.3 (C)
unnamed: D12.3, R22.1
unnamed: Q2.1 (B), R20.1
unnamed: Q3.1 (B), R21.1
unnamed: Q3.3 (C), R22.2
VBUS: C22.1, D8.2 (A), J3.1 (VBUS)

Notes on the sheet:
Auto program
DTR RTS->EN IO0
USB To TTL Conveter Section
Auto Reset Circuit
Micro USB Interface

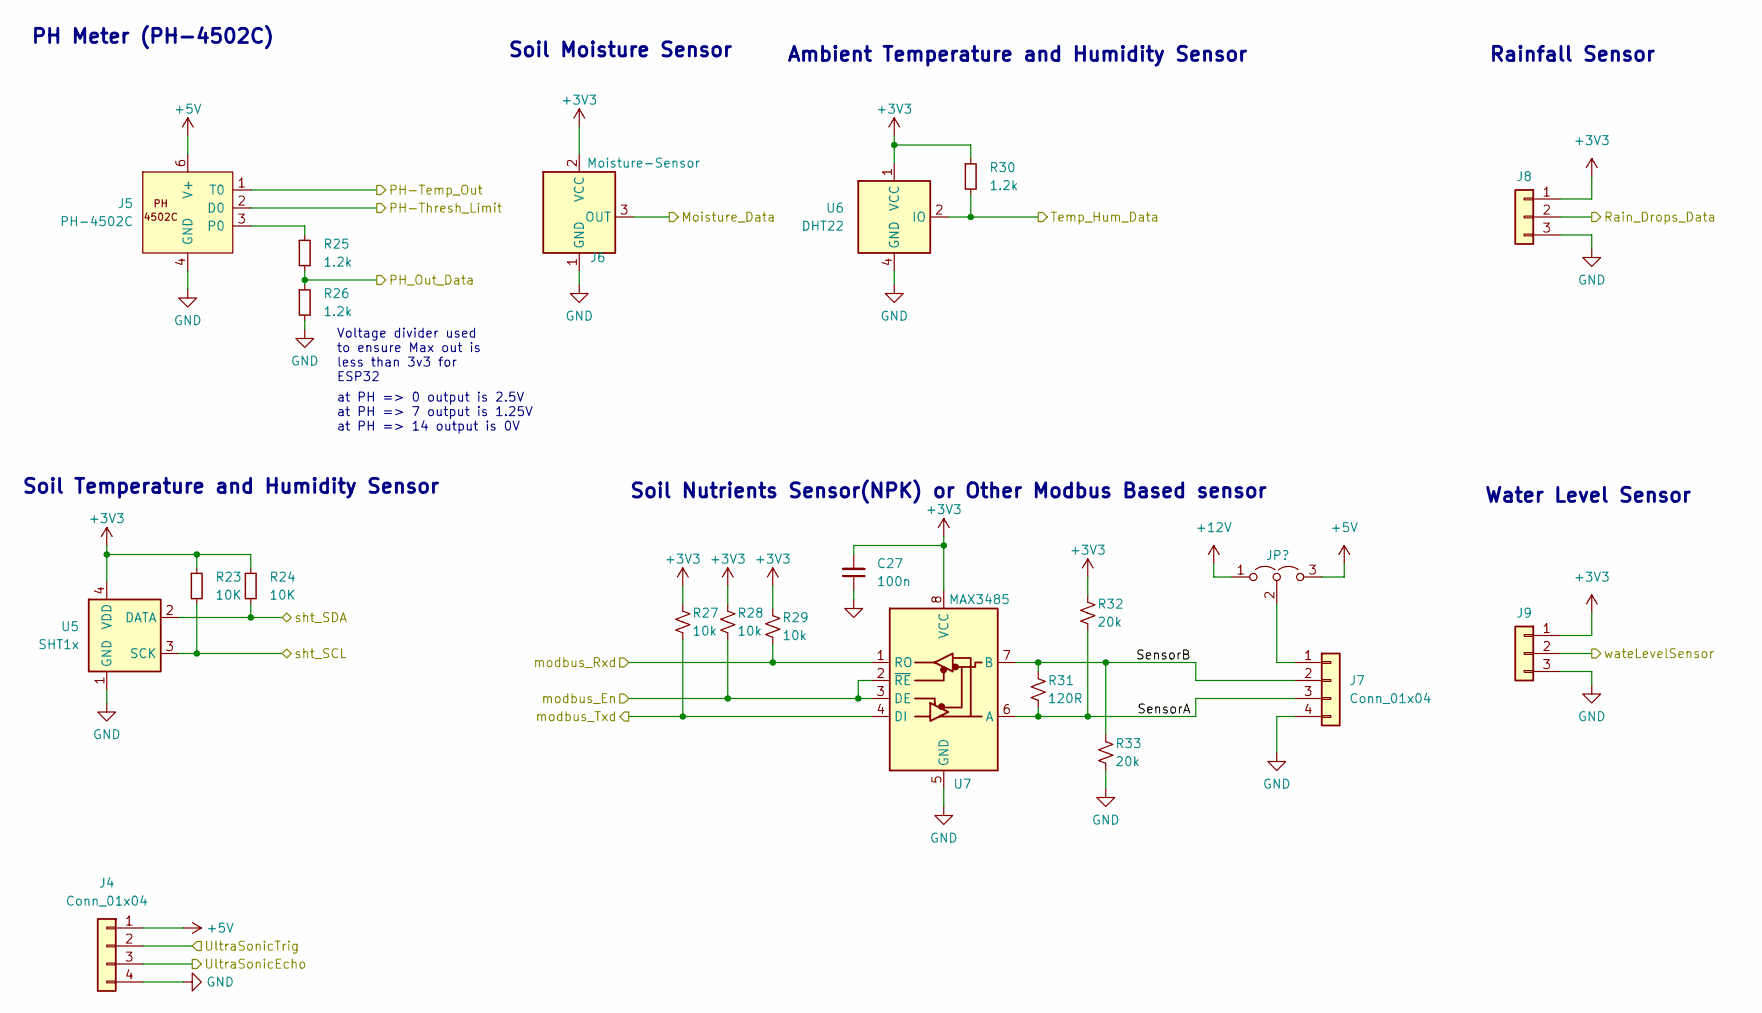
[picture p13: schematic sensors.kicad_sch, MKULIMA IOT DEVICE]

Parts:
C27: 100n; C_0805_2012Metric
J4, J7: Conn_01x04; TerminalBlock_Phoenix_MPT-0,5-4-2.54_1x04_P2.54mm_Horizontal
J5: PH-4502C
J6: Moisture-Sensor; TerminalBlock_Phoenix_MPT-0,5-3-2.54_1x03_P2.54mm_Horizontal
J8, J9: Conn_01x03; TerminalBlock_Phoenix_MPT-0,5-3-2.54_1x03_P2.54mm_Horizontal
R23, R24: 10K; R_0805_2012Metric
R25, R26, R30: 1.2k; R_0805_2012Metric
R27, R28, R29: 10k; R_0805_2012Metric
R31: 120R; R_0805_2012Metric
R32, R33: 20k; R_0805_2012Metric
U5: SHT1x; TerminalBlock_Phoenix_MPT-0,5-4-2.54_1x04_P2.54mm_Horizontal
U6: DHT22; TerminalBlock_Phoenix_MPT-0,5-4-2.54_1x04_P2.54mm_Horizontal
U7: MAX3485; SOP-8_3.9x4.9mm_P1.27mm

Connections:
+3V3: C27.2, J6.2 (VCC), J8.1, J9.1, R23.1, R24.1, R27.1, R28.1, R29.1, R30.1, R32.1, U5.4 (VDD), U6.1 (VCC), U7.8 (VCC); also elsewhere on the board
+5V: J4.1, J5.6 (V+); also elsewhere on the board
+12V: J7.1; also elsewhere on the board
/ESP32_logic_control/PH-Temp_Out: J5.1 (T0); also elsewhere on the board
/ESP32_logic_control/PH-Thresh_Limit: J5.2 (D0); also elsewhere on the board
/ESP32_logic_control/PHData: R25.2, R26.1; also elsewhere on the board
/ESP32_logic_control/RS485En: R28.2, U7.2 (~RE), U7.3 (DE); also elsewhere on the board
/ESP32_logic_control/RS485Rx: R27.2, U7.4 (DI); also elsewhere on the board
/ESP32_logic_control/RS485Tx: R29.2, U7.1 (RO); also elsewhere on the board
/ESP32_logic_control/RainData: J8.2; also elsewhere on the board
/ESP32_logic_control/SonicEcho: J4.3; also elsewhere on the board
/ESP32_logic_control/SonicTrig: J4.2; also elsewhere on the board
/ESP32_logic_control/TempData: R30.2, U6.2 (IO); also elsewhere on the board
/ESP32_logic_control/WaterLevelData: J9.2; also elsewhere on the board
/ESP32_logic_control/moistureData: J6.3 (OUT); also elsewhere on the board
/scl: R23.2, U5.3 (SCK); also elsewhere on the board
/sda: R24.2, U5.2 (DATA); also elsewhere on the board
/sensors/SensorA: J7.3, R31.2, R32.2, U7.6 (A)
/sensors/SensorB: J7.2, R31.1, R33.1, U7.7 (B)
unnamed: J5.3 (P0), R25.1

Notes on the sheet:
Water Level Sensor
Rainfall Sensor
at PH => 0 output is 2.5V at PH => 7 output is 1.25V at PH => 14 output is 0V
Ambient Temperature and Humidity Sensor
Soil Temperature and Humidity Sensor
PH Meter (PH-4502C)
Soil Moisture Sensor
Voltage divider used to ensure Max out is less than 3v3 for ESP32
Soil Nutrients Sensor(NPK) or Other Modbus Based sensor

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
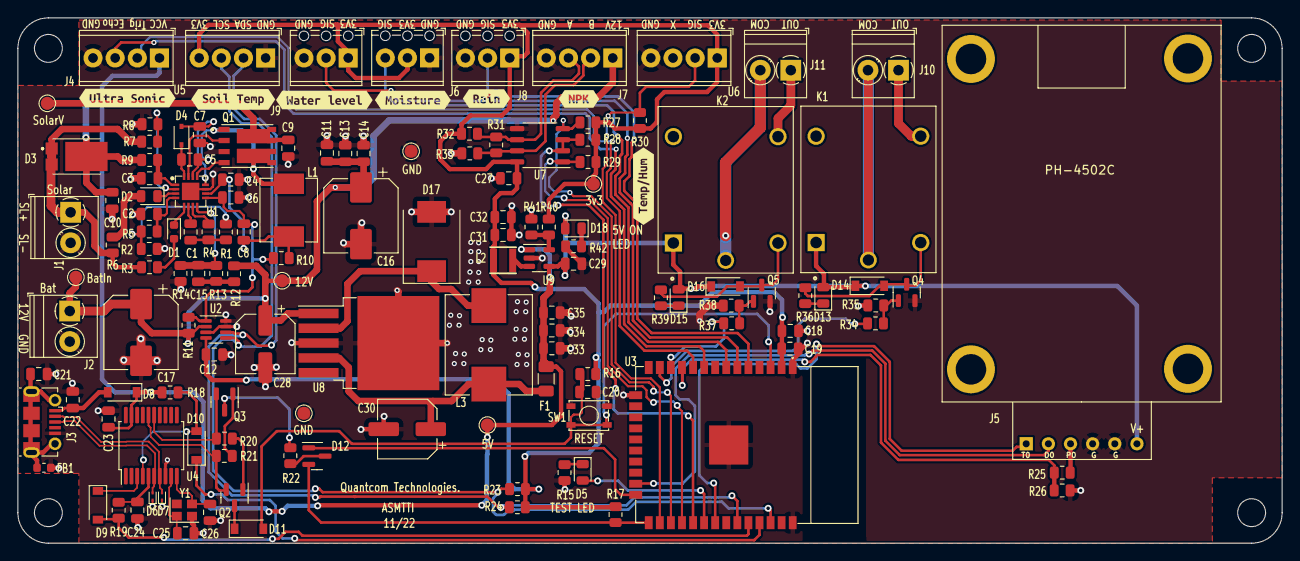
[picture p14: board mkulima_hardware.kicad_pcb from above]

Board: 2 copper layers, 145.0 x 60.2 mm, 143 parts (0 on the bottom side), 83 nets.

Other parts of the board:
kibuzzard-63678A0A: G***; kibuzzard-63678A0A
kibuzzard-63678A18: G***; kibuzzard-63678A18
kibuzzard-63678A29: G***; kibuzzard-63678A29
kibuzzard-636789D9: G***; kibuzzard-636789D9
kibuzzard-636789EB: G***; kibuzzard-636789EB
kibuzzard-636789FE: G***; kibuzzard-636789FE
kibuzzard-6367899D: G***; kibuzzard-6367899D
